wolfgangfriedrich/P42-Watt-A-Live/Design/ASSY_P42-Watt-A-Live_rev1.pdf

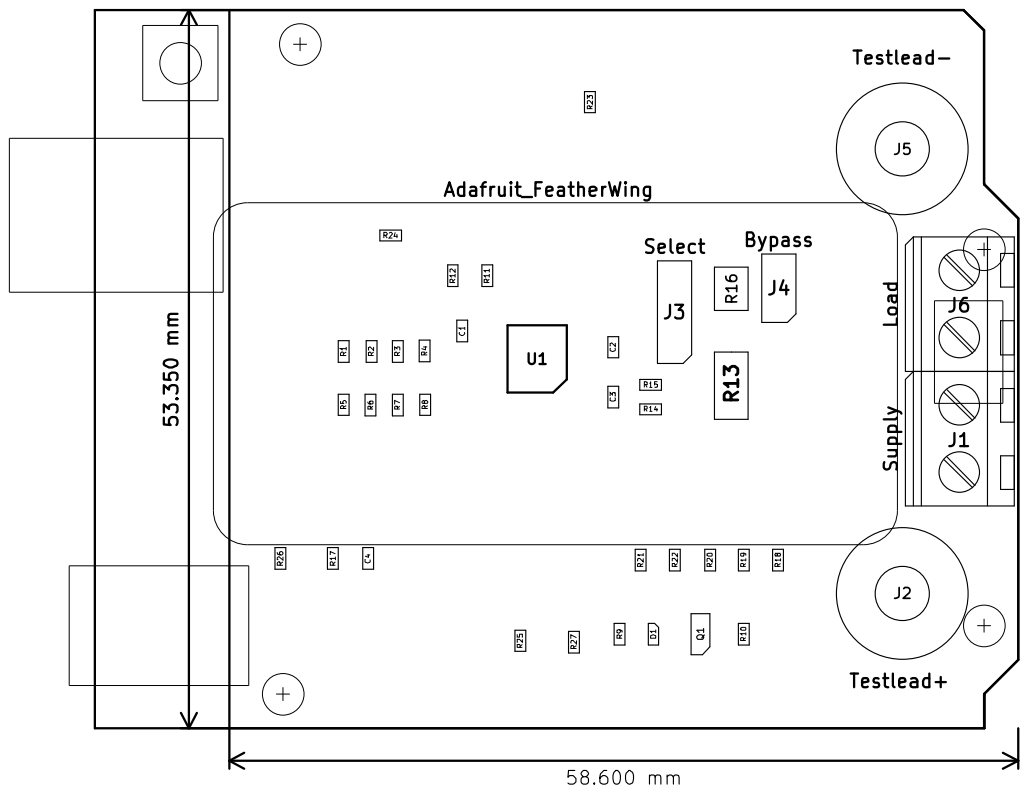
[picture p17: page 1]
