wolfgangfriedrich/P42-Watt-A-Live/Design/SCH_P42-Watt-A-Live_rev1.pdf

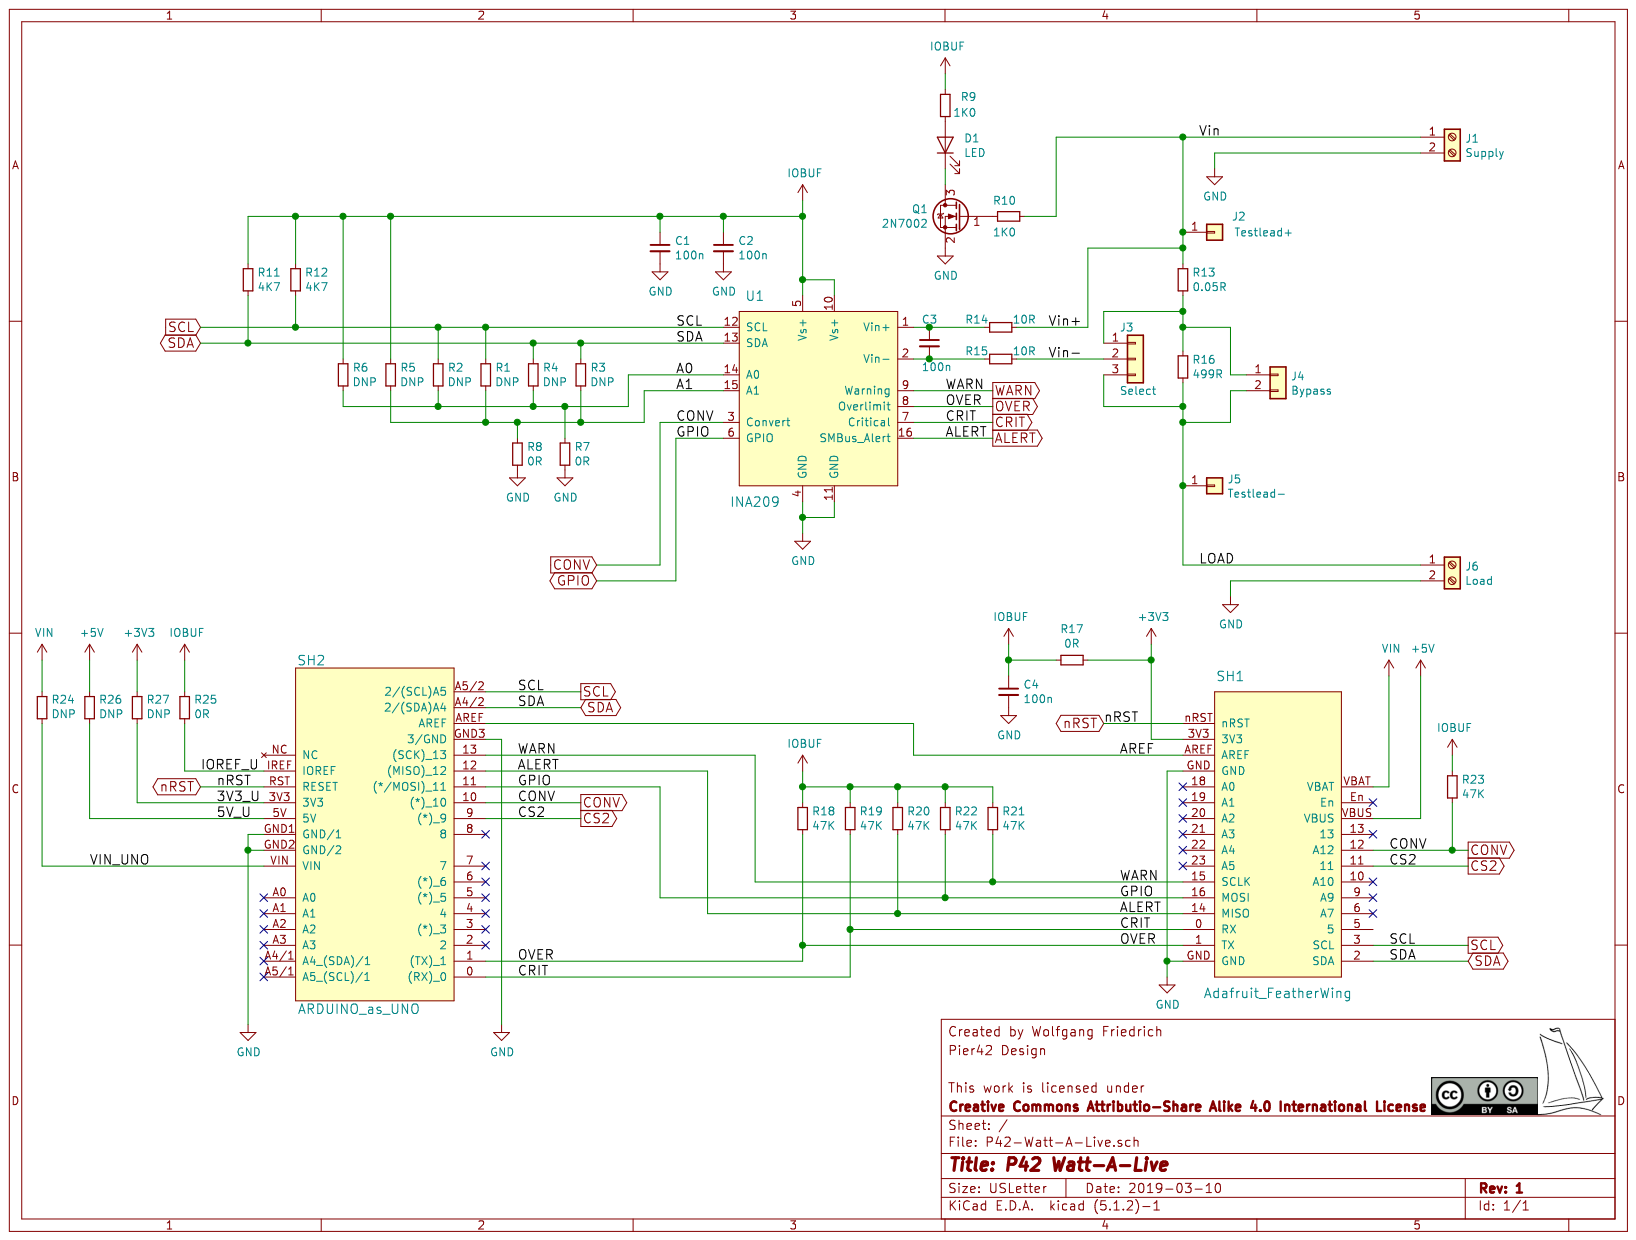
[picture p18: page 1]
