wolfgangfriedrich/P42-Watt-A-Live/(commit log)

2019-06-29 Initial check-in of ver 1
    Documentation, Adruino code, SCH,BOM and AD, Gerbers.
2019-06-30 Power display on serial output
    Power calculation needed adjustment with new shunt resistor
2019-07-08 Fixes in sketch
    Current and shunt voltage printout in sketch.
    Documentation update
    [P42_INA209.ino, ti_ina209.cpp, ti_ina209.h]
2019-09-15 Functions for Current, votage and power
    Added dedicated functions to read current, voltage and power values.
2019-09-15 Code rev2
    Add code for PCB rev2.1 with 0.05R / 499R shunt resistor
2019-09-18 499R Shunt support
    Functions to read current and power now show correct results with the
    499R shunt.
    [P42_INA209_rev2.ino, ti_ina209.cpp, ti_ina209.h]
2019-10-08 Lib and documentation update
    Rev2 Arduino lib update shunt values and output, doc update for
    getCurrent/Voltage/Power() functions
2019-10-23 Good candidate for correct I,U and P calculation
    Change: Current, voltage and power register calc seems correct.
    Change: Differnet ranges for shunt larger than 1 Ohm.
    Add: Debug software UART at Arduino Uno pins 4,5 (Rx,Tx)
    [P42_INA209_rev2.ino, ti_ina209.cpp, ti_ina209.h]
2019-11-16 Update for 4.99 Ohm low current shunt
    R16 had to changed to 4.99 Ohm for good range and accuracy
2019-11-16 Update README.md
    New low current shunt.
